skareagle/halloween-pumpkin-eyes/hardware/eye-socket.stl

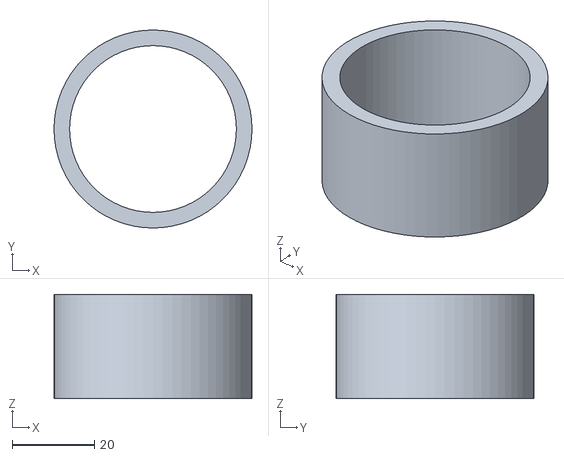
[picture p1: CAD file, 2026-10-25]
hardware/eye-socket.stl
48.3 x 48.3 x 25.4
