skareagle/halloween-pumpkin-eyes/(commit log)

2026-10-25 Add pumpkin eyes guide, sketch and wiring diagrams
    Claude-Session: https://claude.ai/code/session_019fbMQfXSnu3JJem91ThbLv
2026-10-25 Add 3D-printable eye socket and its dimensions
    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
    [eye-socket.stl]
2026-11-01 Use 8 eyes with slower, larger random moves
    The finished pumpkin has 8 servo eyes on channels 0-7. Eyes now hold
    for 1.5 s between moves and each move is at least 40 degrees.
    Claude-Session: https://claude.ai/code/session_01UTM8yn8VQbm6NKp8LM3JqY
2026-11-01 Explain why the pumpkin uses 8 eyes
    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
2026-11-01 Add final pumpkin video to README
    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
